Solodros/le_capybara_keyboard/kicad/wireless-pcb/accelerometer.kicad_sch

## KiCad design kicad/wireless-pcb/accelerometer.kicad_sch (2024-01-24)

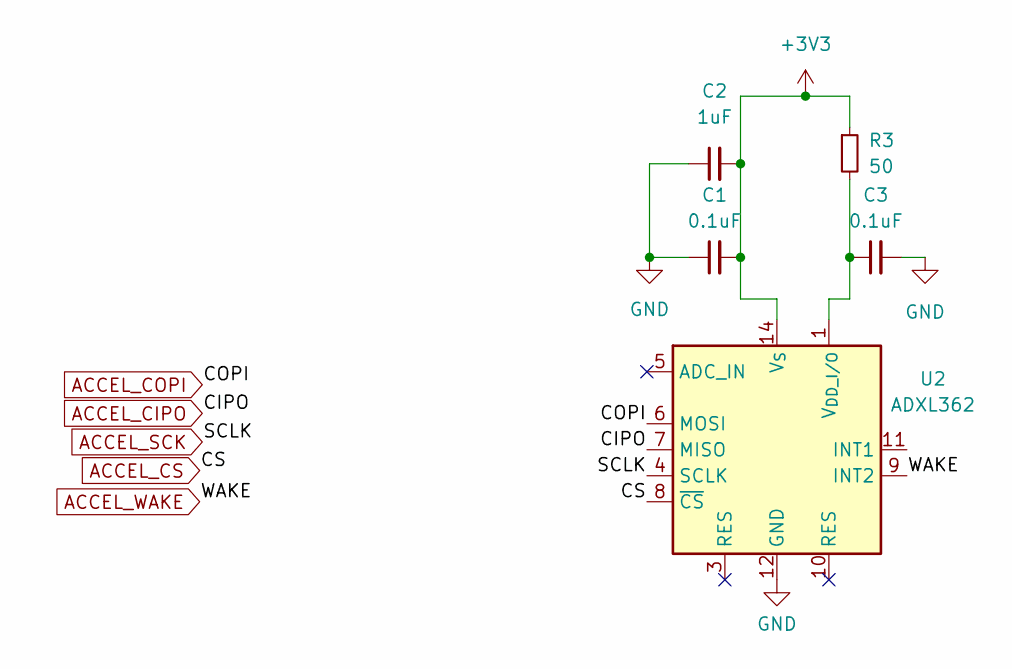
[picture p1: schematic accelerometer.kicad_sch]

Parts:
C1, C3: 0.1uF; C_0402_1005Metric
C2: 1uF; C_0603_1608Metric
R3: 50; R_0402_1005Metric
U2: ADXL362; Analog_LGA-16_3.25x3mm_P0.5mm_LayoutBorder3x5y; MPN ADXL362BCCZ-RL7; LCSC C192252

Connections:
+3V3: C1.2, C2.2, R3.1, U2.14 (V_{S})
ACCEL_CIPO: U2.7 (MISO)
ACCEL_COPI: U2.6 (MOSI)
ACCEL_CS: U2.8 (~CS)
ACCEL_SCK: U2.4 (SCLK)
ACCEL_WAKE: U2.9 (INT2)
GND: C1.1, C2.1, C3.2, U2.12 (GND), U2.13 (GND), U2.16 (GND)
unnamed: C3.1, R3.2, U2.1 (V_{DD_I/O})
