Solodros/le_capybara_keyboard/kicad/wireless-pcb/analog.kicad_sch

## KiCad design kicad/wireless-pcb/analog.kicad_sch (2024-01-24)

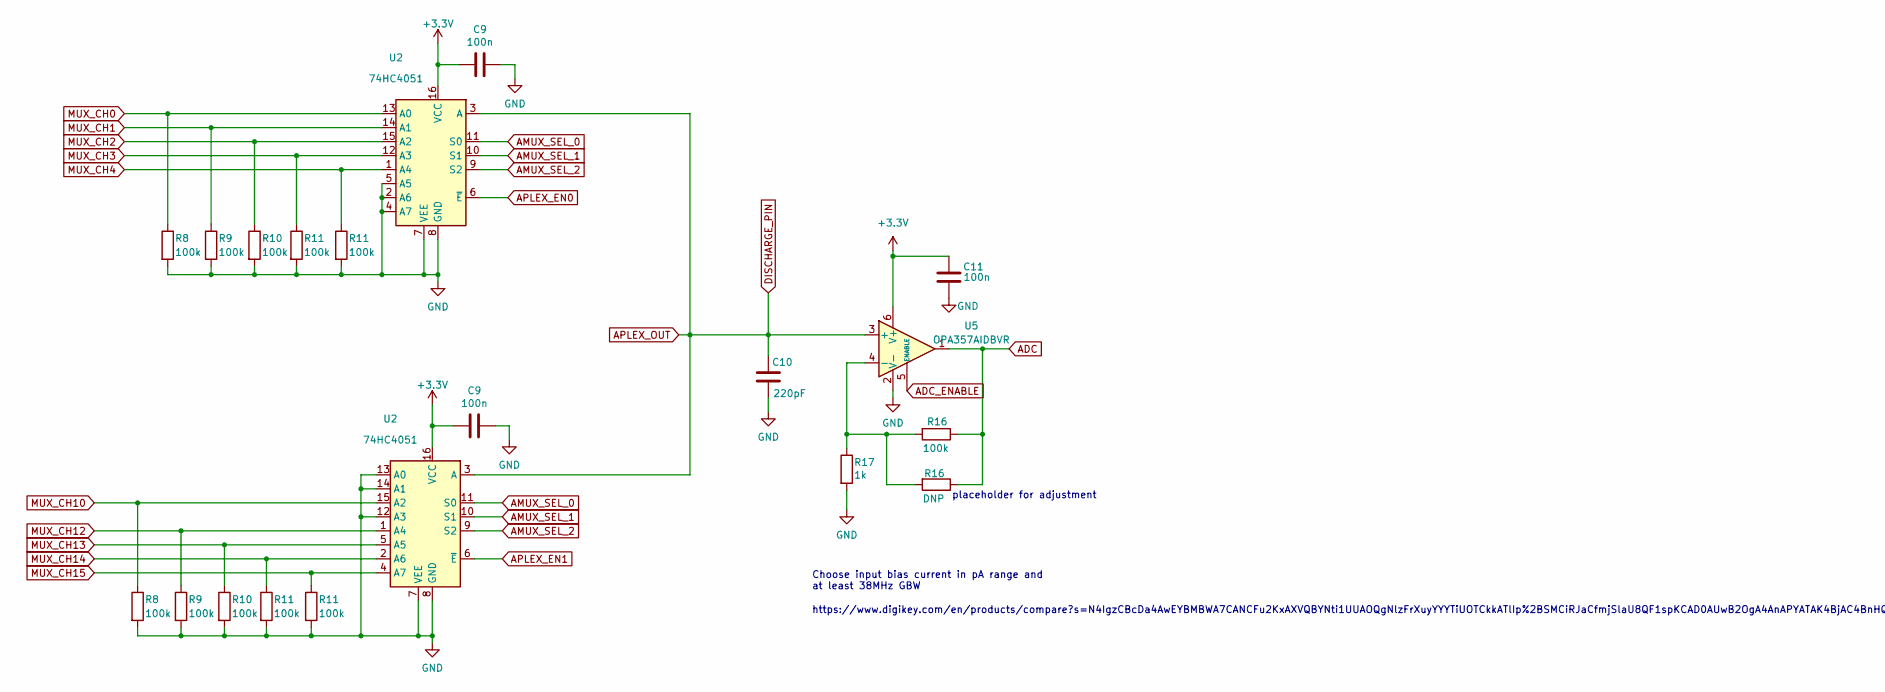
[picture p2: schematic analog.kicad_sch, part in row 1, column 1]

Parts:
C9, C11: 100n; C_0402_1005Metric; LCSC C307331
C10: 220pF; C_0402_1005Metric; LCSC C1530
R8, R9, R10, R11: 100k; R_0402_1005Metric; LCSC C25741
R16: DNP; R_0402_1005Metric
R17: 1k; R_0402_1005Metric; LCSC C11702
U2: 74HC4051; TSSOP-16_4.4x5mm_P0.65mm; MPN 74HC4051PW,118; LCSC C5645
U5: OPA357AIDBVR; SOT-23-6; MPN OPA357AIDBVR; LCSC C139385

Connections:
+3.3V: C9.2, C11.2, U2.16 (VCC), U5.6 (V+)
ADC: R16.1, U5.1
ADC_ENABLE: U5.5 (ENABLE)
AMUX_SEL_0: U2.11 (S0)
AMUX_SEL_1: U2.10 (S1)
AMUX_SEL_2: U2.9 (S2)
APLEX_EN0: U2.6 (~E)
APLEX_EN1: U2.6 (~E)
APLEX_OUT: C10.1, U2.3 (A), U5.3 (+)
GND: C9.1, C10.2, C11.1, R8.2, R9.2, R10.2, R11.2, R17.2, U2.2 (A6), U2.4 (A7), U2.5 (A5), U2.7 (VEE), U2.8 (GND), U2.12 (A3), U2.13 (A0), U2.14 (A1), U5.2 (V-)
MUX_CH0: R8.1, U2.13 (A0)
MUX_CH1: R9.1, U2.14 (A1)
MUX_CH2: R10.1, U2.15 (A2)
MUX_CH3: R11.1, U2.12 (A3)
MUX_CH4: R11.1, U2.1 (A4)
MUX_CH10: R8.1, U2.15 (A2)
MUX_CH12: R9.1, U2.1 (A4)
MUX_CH13: R10.1, U2.5 (A5)
MUX_CH14: R11.1, U2.2 (A6)
MUX_CH15: R11.1, U2.4 (A7)
unnamed: R16.2, R17.1, U5.4 (-)

Notes on the sheet:
placeholder for adjustment
https://www.digikey.com/en/products/compare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…
Choose input bias current in pA range and at least 38MHz GBW
