Solodros/le_capybara_keyboard/kicad/wireless-pcb/key_matrix.kicad_sch

## KiCad design kicad/wireless-pcb/key_matrix.kicad_sch (2024-01-24)

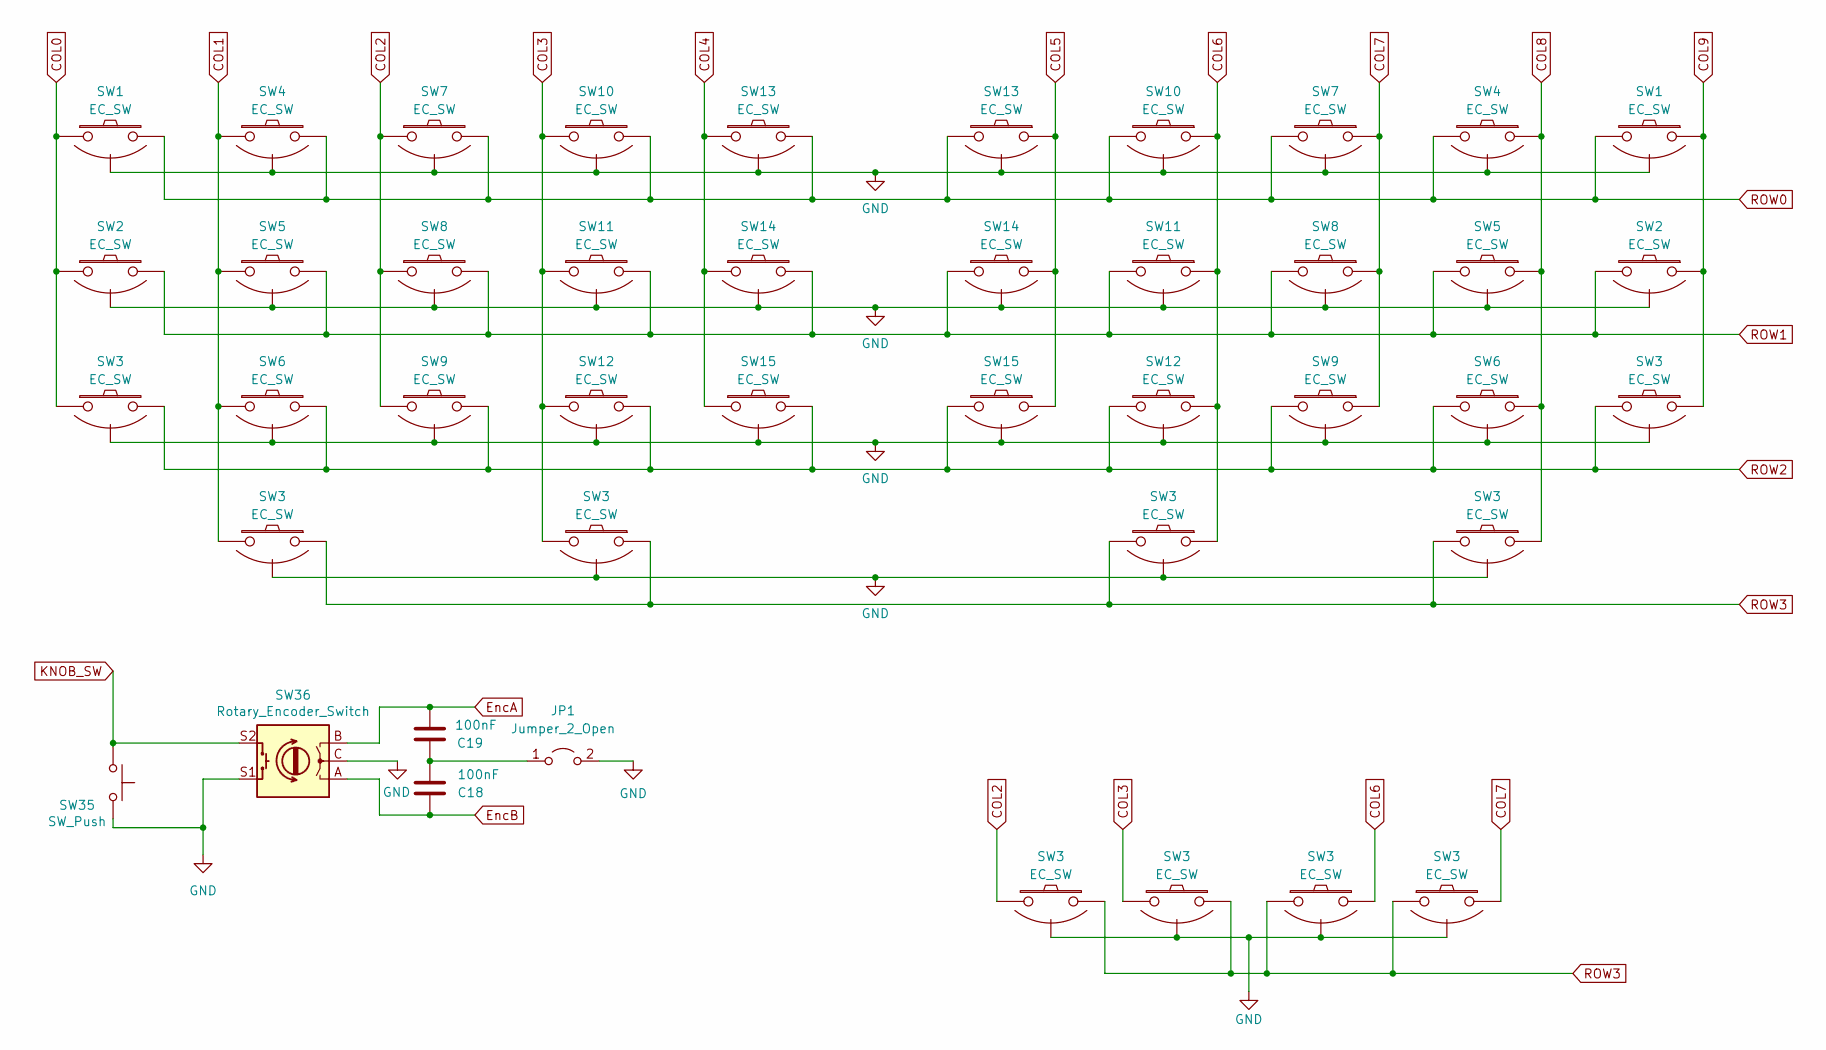
[picture p3: schematic key_matrix.kicad_sch]

Parts:
C18, C19: 100nF; C_0402_1005Metric; LCSC C307331
JP1: Jumper_2_Open; SolderJumper-2_P1.3mm_Open_RoundedPad1.0x1.5mm
SW1, SW2, SW4, SW5, SW6, SW7, SW8, SW9, SW10, SW11, SW12, SW13, SW14, SW15: EC_SW; capy_pad_1U_90deg
SW3: EC_SW; capy_pad_2U_90deg
SW35: SW_Push; MX-Solderable-1U
SW36: Rotary_Encoder_Switch; ROT_Alps_EC11E-Switch

Connections:
COL0: SW1.1, SW2.1, SW3.1
COL1: SW3.2, SW4.1, SW5.1, SW6.1
COL2: SW3.2, SW7.1, SW8.1, SW9.1
COL3: SW3.2, SW10.1, SW11.1, SW12.1
COL4: SW13.1, SW14.1, SW15.1
COL5: SW13.1, SW14.2, SW15.1
COL6: SW3.1, SW3.2, SW10.1, SW11.1, SW12.1
COL7: SW3.2, SW7.1, SW8.1, SW9.1
COL8: SW3.1, SW4.1, SW5.1, SW6.1
COL9: SW1.1, SW2.1, SW3.1
EncA: C19.1, SW36.B
EncB: C18.1, SW36.A
GND: JP1.2 (B), SW1.3 (SG), SW2.3 (SG), SW3.3 (SG), SW4.3 (SG), SW5.3 (SG), SW6.3 (SG), SW7.3 (SG), SW8.3 (SG), SW9.3 (SG), SW10.3 (SG), SW11.3 (SG), SW12.3 (SG), SW13.3 (SG), SW14.3 (SG), SW15.3 (SG), SW35.2, SW36.C, SW36.S1
KNOB_SW: SW35.1, SW36.S2
unnamed: C18.2, C19.2, JP1.1 (A)
ROW0: SW1.2, SW4.2, SW7.2, SW10.2, SW13.2
ROW1: SW2.2, SW5.2, SW8.2, SW11.2, SW14.1, SW14.2
ROW2: SW3.2, SW6.2, SW9.2, SW12.2, SW15.2
ROW3: SW3.1, SW3.2
