Solodros/le_capybara_keyboard/kicad/wireless-pcb/le_zapybara.kicad_sch

## KiCad design kicad/wireless-pcb/le_zapybara.kicad_sch (2024-01-24)

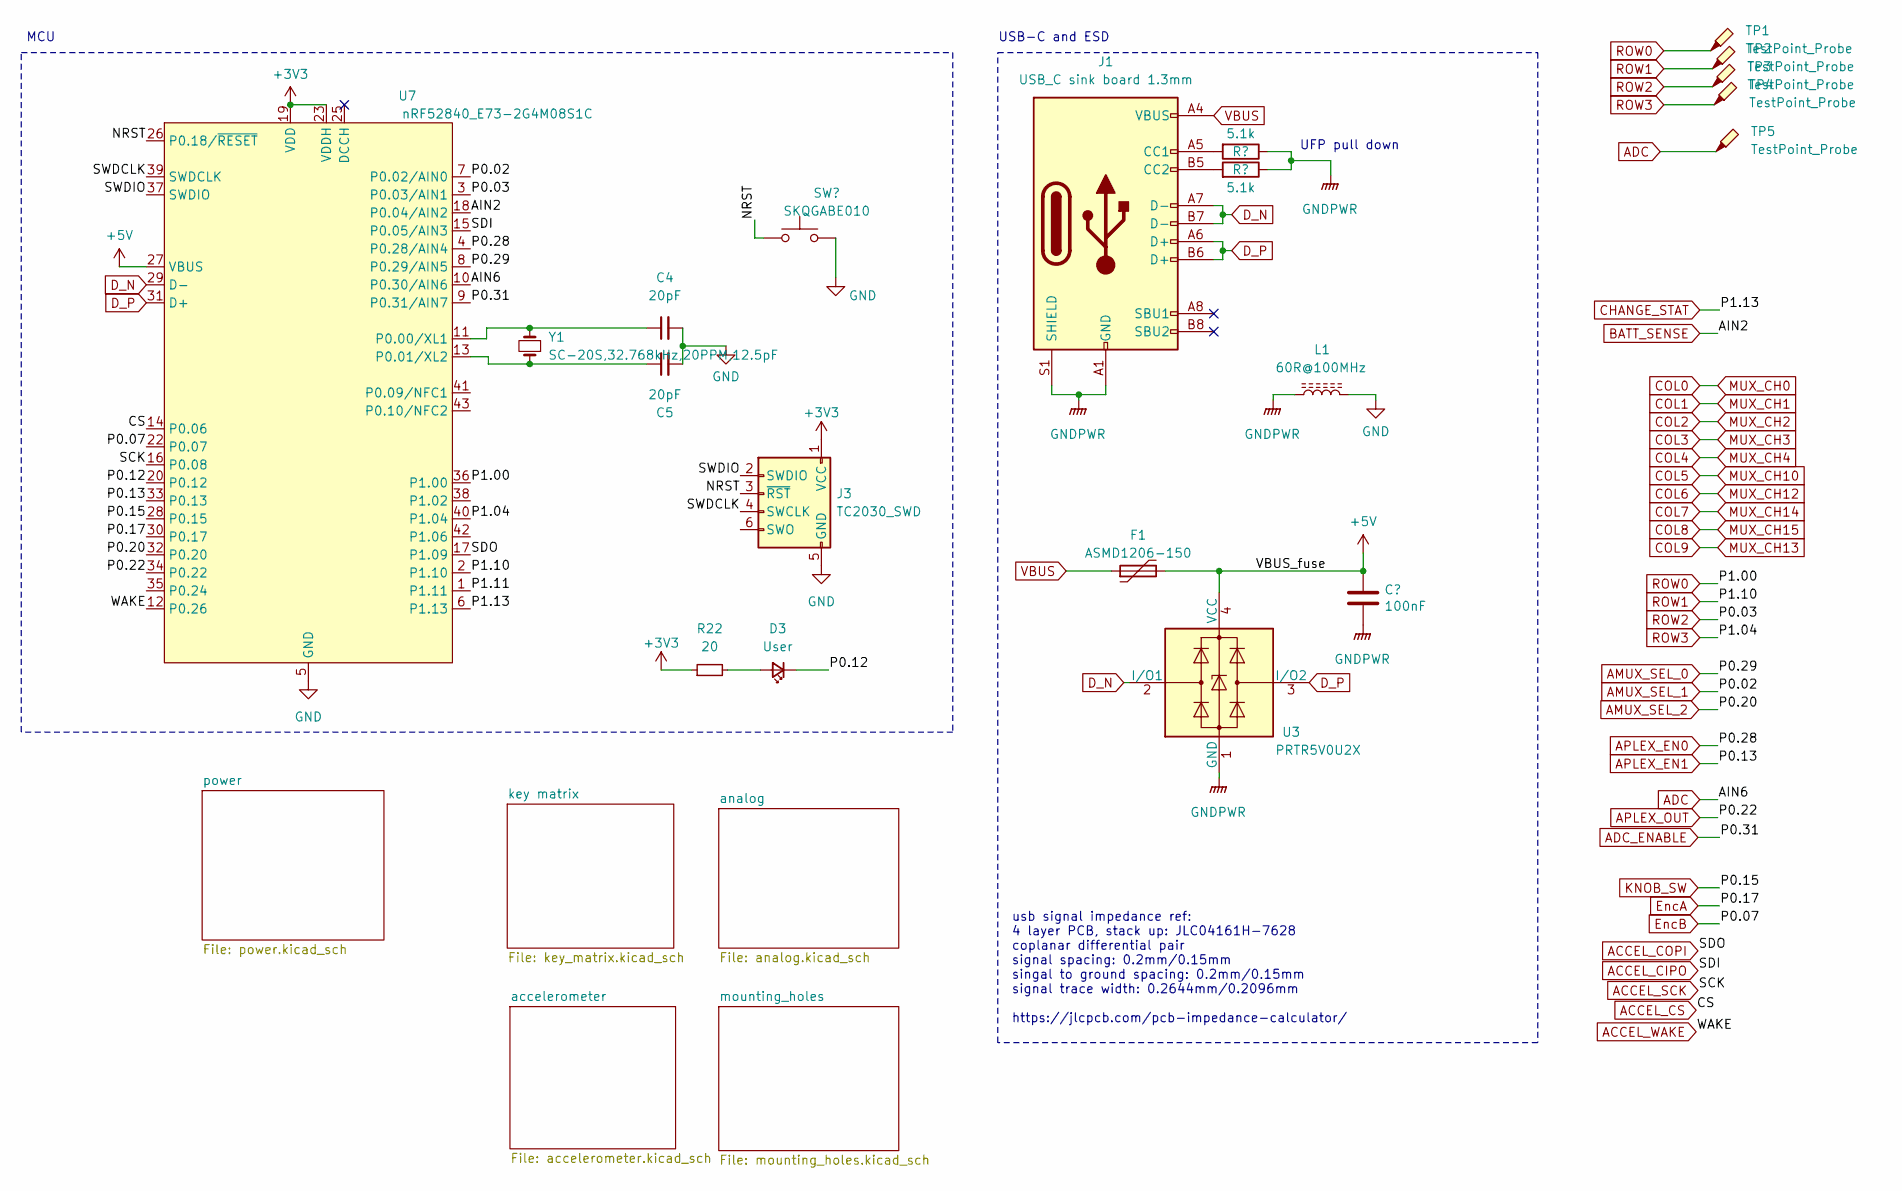
[picture p4: schematic le_zapybara.kicad_sch]

Parts:
C4, C5: 20pF; C_0402_1005Metric
C12: 100nF; C_0402_1005Metric; LCSC C307331
D3: User; LED_0805_2012Metric; MPN 17-21/BHC-AL2M2TY/3T; LCSC C94613
F1: ASMD1206-150; Fuse_1206_3216Metric; LCSC C135341
J1: USB_C sink board 1.3mm; USB4510031A; JlcRotOffset 180
J3: TC2030_SWD; CON_TC2030_outlined
L1: 60R@100MHz; L_1206_3216Metric; Manufacturer Part No MLB3216-600P4A(f); LCSC C33600
R1, R2: 5.1k; R_0402_1005Metric
R22: 20; R_0402_1005Metric; LCSC C2828866
SW37: SKQGABE010; SW_SPST_SKQG_WithoutStem; LCSC C115351
TP1, TP2, TP3, TP4, TP5: TestPoint_Probe; TestPoint_Pad_D1.5mm
U3: PRTR5V0U2X; SOT-143; LCSC C2827688
U7: nRF52840_E73-2G4M08S1C; LCSC C356849
Y1: SC-20S,32.768kHz,20PPM,12.5pF; Crystal_SMD_2012-2Pin_2.0x1.2mm; MPN Seiko SC-20S; LCSC C97603

Connections:
+3V3: J3.1 (VCC), R22.1, U7.19 (VDD), U7.23 (VDDH)
+5V: C12.1, F1.2, U3.4 (VCC), U7.27 (VBUS)
ACCEL_CIPO: U7.15 (P0.05/AIN3)
ACCEL_COPI: U7.17 (P1.09)
ACCEL_CS: U7.14 (P0.06)
ACCEL_SCK: U7.16 (P0.08)
ACCEL_WAKE: U7.12 (P0.26)
ADC: TP5.1, U7.10 (P0.30/AIN6)
ADC_ENABLE: U7.9 (P0.31/AIN7)
AMUX_SEL_0: U7.8 (P0.29/AIN5)
AMUX_SEL_1: U7.7 (P0.02/AIN0)
AMUX_SEL_2: U7.32 (P0.20)
APLEX_EN0: U7.4 (P0.28/AIN4)
APLEX_EN1: U7.33 (P0.13)
APLEX_OUT: U7.34 (P0.22)
BATT_SENSE: U7.18 (P0.04/AIN2)
CHANGE_STAT: U7.6 (P1.13)
D_N: J1.A7 (D-), J1.B7 (D-), U3.2 (I/O1), U7.29 (D-)
D_P: J1.A6 (D+), J1.B6 (D+), U3.3 (I/O2), U7.31 (D+)
EncA: U7.30 (P0.17)
EncB: U7.22 (P0.07)
GND: C4.2, C5.2, J3.5 (GND), L1.2, SW37.2, U7.5 (GND), U7.21 (GND), U7.24 (GND)
GNDPWR: C12.2, J1.A1 (GND), J1.A12 (GND), J1.B1 (GND), J1.B12 (GND), J1.S1 (SHIELD), L1.1, R1.1, R2.1, U3.1 (GND)
KNOB_SW: U7.28 (P0.15)
NRST: J3.3 (~RST), SW37.1, U7.26 (P0.18/~RESET)
unnamed: C4.1, U7.11 (P0.00/XL1), Y1.2
unnamed: C5.1, U7.13 (P0.01/XL2), Y1.1
unnamed: D3.2 (A), R22.2
unnamed: J1.A5 (CC1), R1.2
unnamed: J1.B5 (CC2), R2.2
P0.12: D3.1 (K), U7.20 (P0.12)
P1.11: U7.1 (P1.11)
ROW0: TP1.1, U7.36 (P1.00)
ROW1: TP2.1, U7.2 (P1.10)
ROW2: TP3.1, U7.3 (P0.03/AIN1)
ROW3: TP4.1, U7.40 (P1.04)
SWDCLK: J3.4 (SWCLK), U7.39 (SWDCLK)
SWDIO: J3.2 (SWDIO), U7.37 (SWDIO)
VBUS: F1.1, J1.A4 (VBUS), J1.A9 (VBUS), J1.B4 (VBUS), J1.B9 (VBUS)

Notes on the sheet:
UFP pull down
usb signal impedance ref: 4 layer PCB, stack up: JLC04161H-7628 coplanar differential pair signal spacing: 0.2mm/0.15mm singal to ground spacing: 0.2mm/0.15mm signal trace width: 0.2644mm/0.2096mm https://jlcpcb.com/pcb-impedance-calculator/
MCU
USB-C and ESD
