Solodros/le_capybara_keyboard/kicad/wireless-pcb/mounting_holes.kicad_sch

## KiCad design kicad/wireless-pcb/mounting_holes.kicad_sch (2024-01-08)

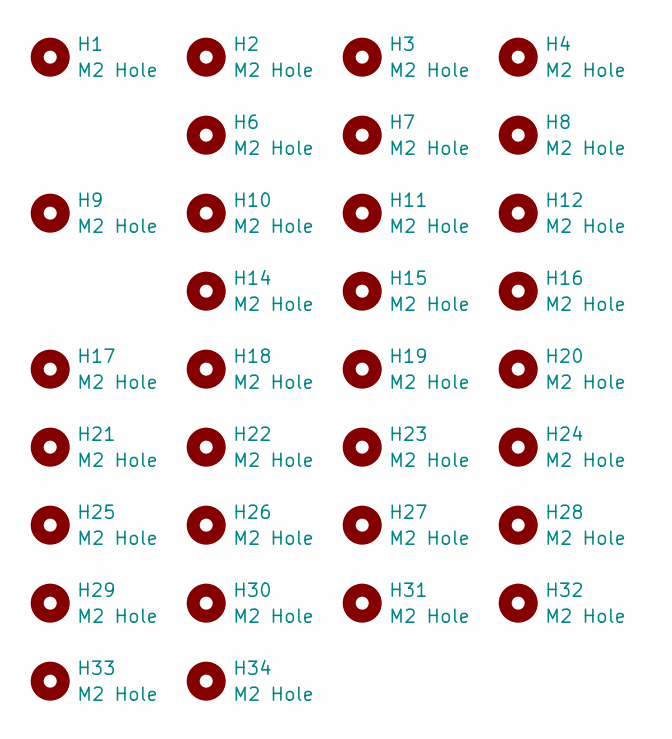
[picture p5: schematic mounting_holes.kicad_sch]

Parts:
H1, H2, H3, H4, H6, H7, H8, H9, H10, H11, H12, H14, H15, H16, H17, H18, H19, H20, H21, H22, H23, H24, H25, H26, H27, H28, H29, H30, H31, H32, H33, H34: M2 Hole; MountingHole_2.2mm_M2
