Solodros/le_capybara_keyboard/kicad/wireless-pcb/power.kicad_sch

## KiCad design kicad/wireless-pcb/power.kicad_sch (2024-01-24)

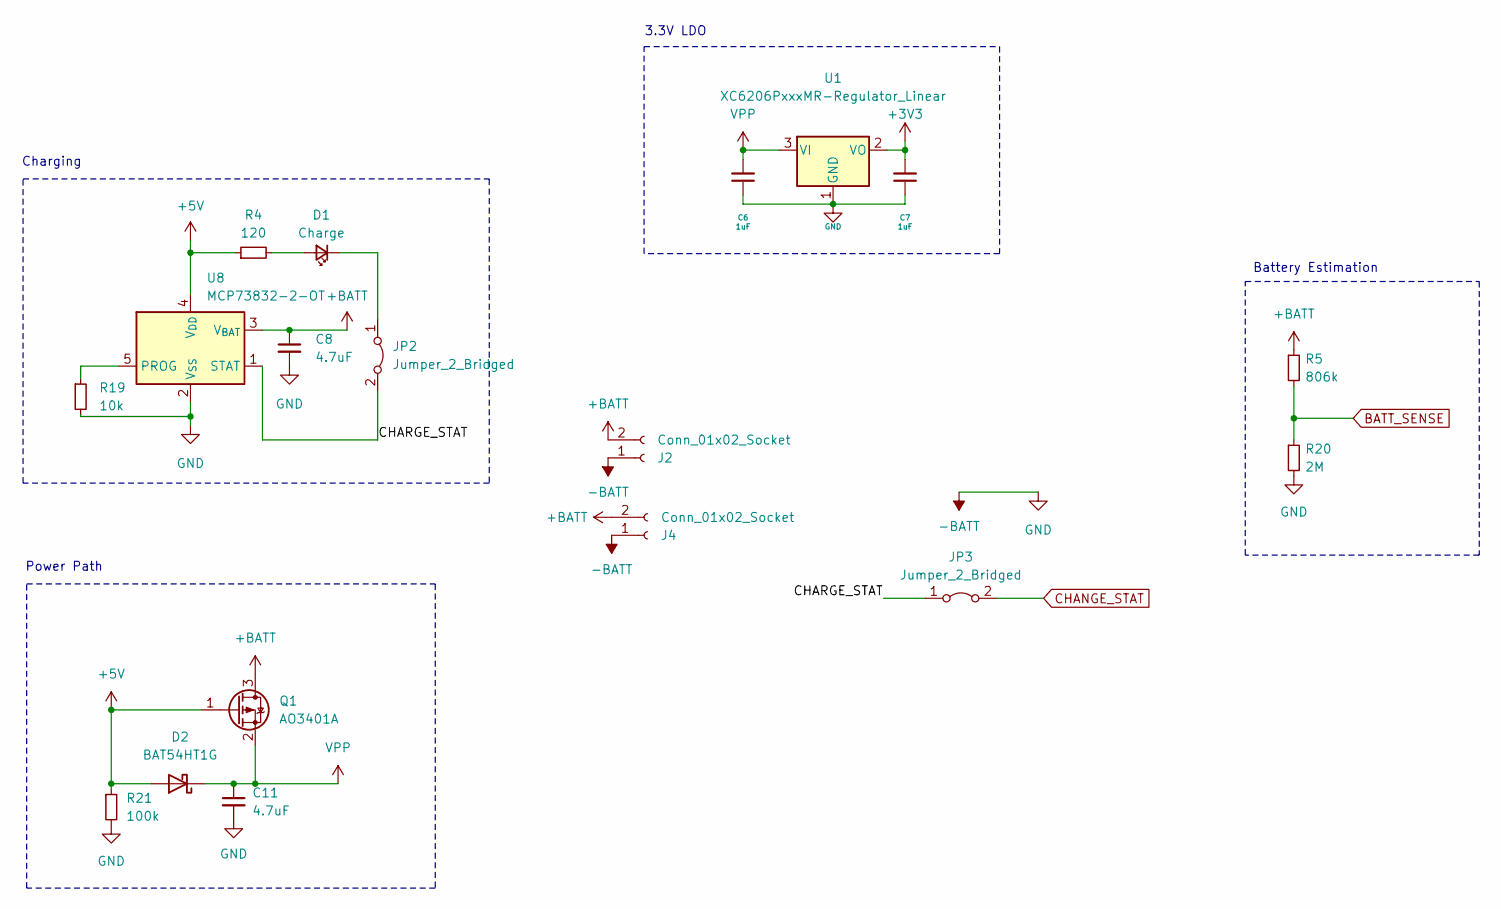
[picture p6: schematic power.kicad_sch]

Parts:
C6, C7: 1uF; C_0402_1005Metric; LCSC C52923
C8, C11: 4.7uF; C_0402_1005Metric; LCSC C1779
D1: Charge; LED_0805_2012Metric; MPN Everlight Elec 17-21SURC/S530-A3/4T; LCSC C2943978
D2: BAT54HT1G; D_SOD-323; MPN BAT54HT1G; LCSC C179609
J2: Conn_01x02_Socket; JST_SH_SM02B-SRSS-TB_1x02-1MP_P1.00mm_Horizontal; MPN SH-SM02B (SRSS)-TB
J4: Conn_01x02_Socket; PinHeader_1x02_P2.54mm_Vertical
JP2, JP3: Jumper_2_Bridged; SolderJumper-2_P1.3mm_Bridged_RoundedPad1.0x1.5mm
Q1: AO3401A; SOT-23; MPN AO3401A; LCSC C15127
R4: 120; R_0402_1005Metric; LCSC C2828866
R5: 806k; R_0402_1005Metric; LCSC C3016043
R19: 10k; R_0402_1005Metric; LCSC C100047
R20: 2M; R_0402_1005Metric; LCSC C228716
R21: 100k; R_0402_1005Metric; LCSC C96346
U1: XC6206PxxxMR-Regulator_Linear; SOT-23; MPN XC6206P332MR; LCSC C5446
U8: MCP73832-2-OT; SOT-23-5; MPN MCP73832-2-OT; LCSC C38066

Connections:
+3V3: C7.2, U1.2 (VO)
+5V: D2.2 (A), Q1.1 (G), R4.1, R21.1, U8.4 (V_{DD})
+BATT: C8.1, J2.2, J4.2, Q1.3 (D), R5.1, U8.3 (V_{BAT})
-BATT: C6.1, C7.1, C8.2, C11.2, J2.1, J4.1, R19.2, R20.2, R21.2, U1.1 (GND), U8.2 (V_{SS})
BATT_SENSE: R5.2, R20.1
CHANGE_STAT: JP3.2 (B)
CHARGE_STAT: JP2.2 (B), JP3.1 (A), U8.1 (STAT)
unnamed: D1.1 (K), JP2.1 (A)
unnamed: D1.2 (A), R4.2
unnamed: R19.1, U8.5 (PROG)
VPP: C6.2, C11.1, D2.1 (K), Q1.2 (S), U1.3 (VI)

Notes on the sheet:
3.3V LDO
Charging
Power Path
Battery Estimation
