Solodros/le_capybara_keyboard/(commit log)

2024-01-08 Initial Zapybara work.
    [accelerometer.kicad_sch, analog.kicad_sch, key_matrix.kicad_sch, le_zapybara.kicad_sch, mounting_holes.kicad_sch, power.kicad_sch]
2024-01-09 Various cleanup, better pin selection, etc.
    [accelerometer.kicad_sch, key_matrix.kicad_sch, le_zapybara.kicad_sch, power.kicad_sch]
2024-01-24 BOM tweaks, add some test points, minor placement tweaks.
    [accelerometer.kicad_sch, analog.kicad_sch, key_matrix.kicad_sch, le_zapybara.kicad_sch, power.kicad_sch]
2024-01-24 Add some jumpers for the charge status bits to be safe.
    [power.kicad_sch]
2024-01-24 Skip jumpers in the BOM.
    [power.kicad_sch]
